JasXSL/VibHub-ESP8266/Devboard_1.1/README.md

# Work in progress

Goal is to correct the errors in rev 1.0 and make additional improvements in the case additional devboard PCBs are made (likely given how cheap that is)

## TODO

~~Swap SDA/SCL pins on ESP8266 and header~~

~~Change I2C address to something not reserved (https://www.i2c-bus.org/addressing/)~~
Uses 0x60

~~Replace resistor array package to fit 0402 that the EXB28V actually uses (never trust what summary descriptions show)~~ Using EXB38V/0603x4 instead

~~Move buttons, obstructed by plugin boards~~

~~Add LED to driver enable/sleep, GPIO15~~

~~Add 0805 resistor (possibly 51R or 220R) to RGB LED 3v3 to limit overall brightness as needed~~

~~Add more spacing between GND pad and pins on DRV8833 package~~

~~Consider switching USB output ports V+ through 2.5mm jack switch to allow using only one port per channel at a time~~

~~Move jacks close to board edge~~

~~Add I2C header for great justice~~
Meh

~~Debug why auto flash and programming doesn't work~~
Reworked circuit, should work now

~~Remove auto boot mode since it may not even work and isn't required~~

~~Add instructions to slikscreen for manual flash boot mode~~
Not enough room to waste for this

~~Add FTDI style header near relocated flash and reboot pins (GND, CTS, VCC, TXD, RXD, RTS)~~

~~Add lables to FTDI header~~

~~Enlarged all text on silkscreen so its readable~~

~~Replace battery input with JST-XH (only needs silkscreen changes and more clearance)~~
Should be enough room now

~~Replace fuse to larger package with higher voltage rating~~

Other things
