JasXSL/VibHub-ESP8266/Devboard_1.0/bom.ods

Qty | Value | Device | Package | Parts | Description | DIGIKEY | MF | MPN
3 | 1.0uF | CAPACITOR-1206 | C1206 | C1, C2, C4 | Capacitors | 1276-1783-1-ND | Samsung | CL31B105KOFNNNE
1 | 100uF/10V | CAPACITOR_POLPANASONIC_D | PANASONIC_D | C12 | Polarized Capacitors | PCE3866CT-ND | Panasonic | EEE-1AA101SP
4 | 10uF/16V | CAPACITOR-1206 | C1206 | C3, C5, C6, C9 | Capacitors | 1276-1312-1-ND | Samsung | CL31F106ZOHNNNE
2 | 0.1uF/16V | CAPACITOR-1206 | C1206 | C7, C10 | Capacitors | 399-9305-1-ND | KEMET | C1206C104K4RACTU
2 | 2.2uF/16V | CAPACITOR-1206 | C1206 | C8, C11 | Capacitors | 490-1799-1-ND | Murata | GRM31MR71C225KA35L
1 | RGB | LED-RGB-CAPLCC | P-LCC-4-3 3528 | D1 | Generic 3528 RGB LED | 732-4998-1-ND | Wurth | 150141M173100
8 | Red | LED0805-NO_OUTLINE | CHIPLED_0805_NOOUTLINE | D13, D14, D15, D16, D17, D18, D19, D20 | Generic 0805 LED | 732-4984-1-ND | Wurth | 150080RS75000
1 | 3A/40V/500mV | DIODE-SCHOTTKY-B340A | SMA-DIODE | D2 | Schottky diode | B340A-FDICT-ND | Diodes Incorporated | B340A-13-F
17 | Blue | LED0805-NO_OUTLINE | CHIPLED_0805_NOOUTLINE | D4, D5, D6, D7, D8, D9, D10, D11, D12, D21, D22, D23, D24, D25, D26, D27, D28 | Generic 0805 LED | 732-4982-1-ND | Wurth | 150080BS75000
1 | 6V/2A | PPTC_HALF-AMP | 1206 | F1 | Resettable Fuse PPTC | 507-1809-1-ND | Bel Fuse Inc. | 0ZCJ0200FF2C
1 | PTH-6.0MM | MOMENTARY-SWITCH-SPST-PTH-6.0MM | TACTILE_SWITCH_PTH_6.0MM | S1 | Momentary Switch (Pushbutton) - SPST | 450-1804-ND | TE Connectivity | 1825910-7
2 | SMD-6.0X3.5MM | MOMENTARY-SWITCH-SPST-SMD-6.0X3.5MM | TACTILE_SWITCH_SMD_6.0X3.5MM | FLASH, RESET | Momentary Switch (Pushbutton) - SPST | 450-1140-ND | TE Connectivity | FSMSM
1 | USB-MICROB-2 | USB-MICROB-2 | USB-MICROB-10118194 | J1 | USB Connectors | 609-4618-6-ND | Amphenol FCI | 10118194-0001LF
4 | MJ-2509N | MJ-2509N | MJ-2509N | J10, J11, J12, J13 | Mono Audio Jack, 2.5 MM | CP-M2509N-ND | CUI | MJ-2509N
2 | 1x2M | CONN_02LOCK_LONGPADS | 1X02_LOCK_LONGPADS | J2, J17 | Generic male header
4 | 1x8F | CONN_08FEMALE_LOCK | 1X08_FEMALE_LOCK | J3, J4, J15, J16 | Generic female header | S7006-ND | Sullins | PPTC081LFBN-RC
2 | 1x8M | CONN_08LOCK | 1X08_LOCK | J5, J14 | Generic male header
4 | USB-A-HU | USB-A-HU | USB-A-HU | J6, J7, J8, J9 | USB Connectors | ED2991-ND | On Shore Technology | USB-A1SSW6
1 | DMG2305UX | MOSFET_PCH | SOT23-3 | Q1 | P-channel MOSFETs | DMG2305UX-7DICT-ND | Diodes Incorporated | DMG2305UX
1 | 51R | RESISTOR0805 | R0805 | R1 | Generic 0805 Resistor | P51ACT-ND | Panasonic | ERJ-6GEYJ510V
1 | 220R | RESISTOR0805 | R0805 | R2 | Generic 0805 Resistor | P220ACT-ND | Panasonic | ERJ-6GEYJ221V
1 | 22R | RESISTOR0805 | R0805 | R3 | Generic 0805 Resistor | P22.0CCT-ND | Panasonic | ERJ-6ENF22R0V
2 | ASDFASDFASDFAS | RESISTOR0805 | R0805 | R4, R5 | Generic 0805 Resistor | P10KACT-ND | Panasonic | ERJ-6GEYJ103V
4 | 0.39R | RESISTOR0805 | R0805 | R6, R7, R8, R9 | Generic 0805 Resistor | P19250CT-ND | Panasonic | ERJ-6DQJR39V
7 | 1k | 743C083102JP | 2008, Concave, Long Side Terminals | RN1, RN2, RN3, RN4, RN5, RN6, RN7 | Array Chip Resistor | 743C083102JPCT-ND | CTS | 743C083102JP
2 | 10k | 743C083103JP | 2008, Concave, Long Side Terminals | RN8, RN9 | Array Chip Resistor | 743C083103JPCT-ND | CTS | 743C083103JP
1 | BSS138PS | BSS138PS | SOT363 | T1 | Dual N-Channel MOSFET | 1727-3125-1-ND | NXP | PMGD280UN,115
1 | PCA9634D | PCA9634 | SO-20 | U1 | IC LED DRIVER 20SO | 568-4065-1-ND | NXP | PCA9634D,118
2 | DRV8833C | DRV8833 | HTSSOP16 | U2, U3 | Dual H-Bridge Motor Driver | 296-40078-1-ND | Texas Instruments | DRV8833CPWPR
1 | 3.3V | V_REG_AP2112K-3.3V | SOT23-5 | U4 | 600mA LDO Regulator | AP2112K-3.3TRG1DICT-ND | Diodes Incorporated | AP2112K-3.3TRG1
1 | ESP12 | ESP-12 | ESP-12 | X1
