JasXSL/VibHub-ESP8266/manual.odt

VibHub Dev Kit 1

By JasX

## User Manual

Important Stuff

- The micro-usb connector (the tiny one) is an INPUT only. The maximum power draw is dependent on the power supply used. DO NOT POWER VIBRATOR UNITS FROM A COMPUTER USB PORT OR YOU WILL BREAK THE PORT. For safety reasons we suggest at least 2.2A of current for your power supply. A 1A supply will work if you only use ONE USB vibrator.
- The large USB ports are OUTPUT only. Do not try to power the device from these.
- Remove any vibrators present when plugging the device into a computer to update the software.

# Legal stuff

## The free hardware

THE PERIPHERAL IS PROVIDED "AS IS", WITHOUT WARRANTY OF ANY KIND, EXPRESS OR IMPLIED, INCLUDING BUT NOT LIMITED TO THE WARRANTIES OF MERCHANTABILITY, FITNESS FOR A PARTICULAR PURPOSE AND NONINFRINGEMENT. IN NO EVENT SHALL THE AUTHORS OR COPYRIGHT HOLDERS BE LIABLE FOR ANY CLAIM, DAMAGES OR OTHER LIABILITY, WHETHER IN AN ACTION OF CONTRACT, TORT OR OTHERWISE, ARISING FROM, OUT OF OR IN CONNECTION WITH THE PERIPHERAL OR THE USE OR OTHER DEALINGS IN THE SOFTWARE.

## The software

Copyright 2018 JasX

Permission is hereby granted, free of charge, to any person obtaining a copy of this software and associated documentation files (the "Software"), to deal in the Software without restriction, including without limitation the rights to use, copy, modify, merge, publish, distribute, sublicense, and/or sell copies of the Software, and to permit persons to whom the Software is furnished to do so, subject to the following conditions:

The above copyright notice and this permission notice shall be included in all copies or substantial portions of the Software.

THE SOFTWARE IS PROVIDED "AS IS", WITHOUT WARRANTY OF ANY KIND, EXPRESS OR IMPLIED, INCLUDING BUT NOT LIMITED TO THE WARRANTIES OF MERCHANTABILITY, FITNESS FOR A PARTICULAR PURPOSE AND NONINFRINGEMENT. IN NO EVENT SHALL THE AUTHORS OR COPYRIGHT HOLDERS BE LIABLE FOR ANY CLAIM, DAMAGES OR OTHER LIABILITY, WHETHER IN AN ACTION OF CONTRACT, TORT OR OTHERWISE, ARISING FROM, OUT OF OR IN CONNECTION WITH THE SOFTWARE OR THE USE OR OTHER DEALINGS IN THE SOFTWARE.

Getting Started

1. Plug a micro USB power outlet, such as a phone charger, of at least 1A (2A+ recommended, see IMPORTANT STUFF). The big LED on the top left quadrant should light up and turn blue.
2. Use a wifi-enabled device such as a smartphone, laptop, tablet, or wifi-enabled PC and look at the list of available connections. Find the one named VibHub_<numbers> such as VibHub_7832 and connect to it.
3. The device should ask you to sign in after connecting. If not, try opening a browser and entering the URL 192.168.4.1 to enter the configuration portal.
4. Press “Configure”.
5. Select the wifi network to connect the device to and enter the password (if any).
6. Write down the Device ID on this page, or change it. Treat this like a password, as this is the token that will allow apps to control your device. If you want to revoke all apps access to your device, change the device ID to something nobody will guess.
7. You can leave the server settings as their default values unless you intend on using a custom or your own server (advanced).
8. Press save and wait for the device to restart.
9. If successful, the big LED at the top left should turn green. If it turns blue again, it means the wifi connection failed. Configure the device again with the right credentials.
10. Plug in a USB or phono vibrator. Keep in mind you can only use one device per channel, so plugging a USB and a phone on channel 0 will not work.
11. Find a VibHub app and enter your device ID. It should now be able to control your VibHub device.

# Reconfiguring

There are 2 ways of reconfiguring the device:

1. Press and hold the button on the board for at least 3 seconds. The light will turn blue and you can enter the configuration portal again.
2. Unplug the device. Press and hold the button while plugging in the device. This will reset all device settings, including WiFi, and generate a new Device ID!

Updating the firmware

V1.0 has a header for the Adafruit CP2104 Friend.

V1.1 will use a standard “FTDI cable” header. Such cables and adapters can be found cheaply from Adafruit, Amazon, or other online stores. The Adafruit CP2104 Friend will also work.

1. Install Arduino IDE https://www.arduino.cc/en/Main/Software
2. Install Arduino ESP8266 via boards manager https://github.com/esp8266/Arduino#installing-with-boards-manager
3. Attach USB-to-UART adapter to programming header. Align according to board markings.
4. Plug adapter’s USB to computer. Install drivers for adapter if needed.
5. Download firmware https://github.com/JasXSL/VibHub-ESP8266
6. Open suitable ino file and change config as needed for board (see git readme for this info)
7. In the Arduino IDE, set the following: Tools > Board > NodeMCU 1.0 Tools > Upload Speed > 115200 Tools > Ports > select the COM port for the adapter you’ve plugged in (likely the only one)
8. On the VibHub board, hold down the FLASH button, press RESET, then release FLASH.
9. Sketch > Upload
10. Wait

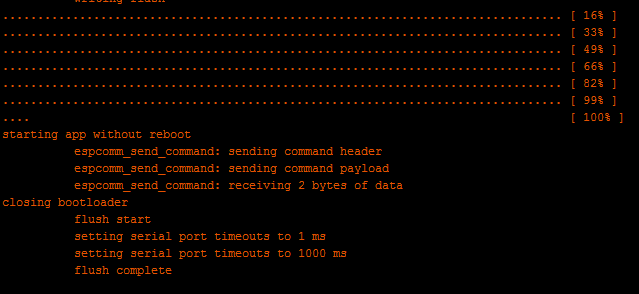
[picture p1: figure]

11. The following means it completed successfully.
12. Profit.

Need additonal help?

Join the JasX discord at discord.jasx.org

Credits

JasX is:

- JasXSL: https://github.com/JasXSL
- Kadah: https://github.com/Kadah

Additional open source/creative commons libraries/assets by:

- WiFiManager by Tzapu: https://github.com/tzapu/WiFiManager
- TweenDuino by StickyWes: https://github.com/stickywes/TweenDuino
- PCA9634 by HydroSense: https://github.com/HydroSense/HydroSense_PCA9634 (https://github.com/HydroSense/HydroSense_PCA9634)
- Padlock icon by game-icons: https://game-icons.net/

TODO: Fill out the rest
