JasXSL/VibHub-ESP8266/(threads)

Thread 2 (2018-01-17):

To do: Select wifi credentials, device ID and server URL via bluetooth.

JasXSL, 2018-01-17:
Also store them on file.

- [ ] Script bluetooth back-end
- [ ] Script bluetooth front end
- [ ] Add read/write of values onto file
- [ ] Add HW button to enable bluetooth
- [ ] Add RGB status LED.

JasXSL, 2018-02-02:
Closing since we're going with the wifi implementation

Closed 2018-02-02.

Thread 3 (2018-01-17):

Device disconnects and reconnects a lot, problem with HW or SW?

JasXSL, 2018-01-17:
Dunno why it does this, but I've set it up to reconnect at least, so it shouldn't be that big of an issue. Might wanna look into it some time tho.

JasXSL, 2018-02-02:
Seems to be fixed with the latest library I think

Closed 2018-02-02.

Thread 4 (2018-01-17):

To do: Programs

JasXSL, 2018-01-17:
Right now the device only supports setting PWM values directly. The node version of VibHub supports programs where it tweens between values. Not sure if we'll have enough memory to do it, but it's probably worth looking into.

JasXSL, 2018-05-02:
Next step will be:

- [ ] Support the GET socket task to load programs via sockets
- [ ] Support RandObj and boolean (use previous) in stage intensity
- [ ] Support RandObj in stage duration
- [ ] Support RandObj in stage repeats

Thread 6 (2018-05-02):

Device shut down without restarting after first wifi settings

JasXSL, 2018-05-02:
Anything past that reboots properly. Maybe an issue of the first write to the file system?

Thread 7 (2018-05-04):

Additional socket tasks needed

JasXSL, 2018-05-04:
Currently I believe we're only accepting "p". The following will also need to be supported:

- [ ] ps - Set a single motor PWM (this could possibly be used for your reverse brake if you wanted)
- GET - Sends a REST request via websockets instead. Only needs to implement the "vib" task
