JasXSL/VibHub-ESP8266/Hardware/vibhub_0.2.pdf

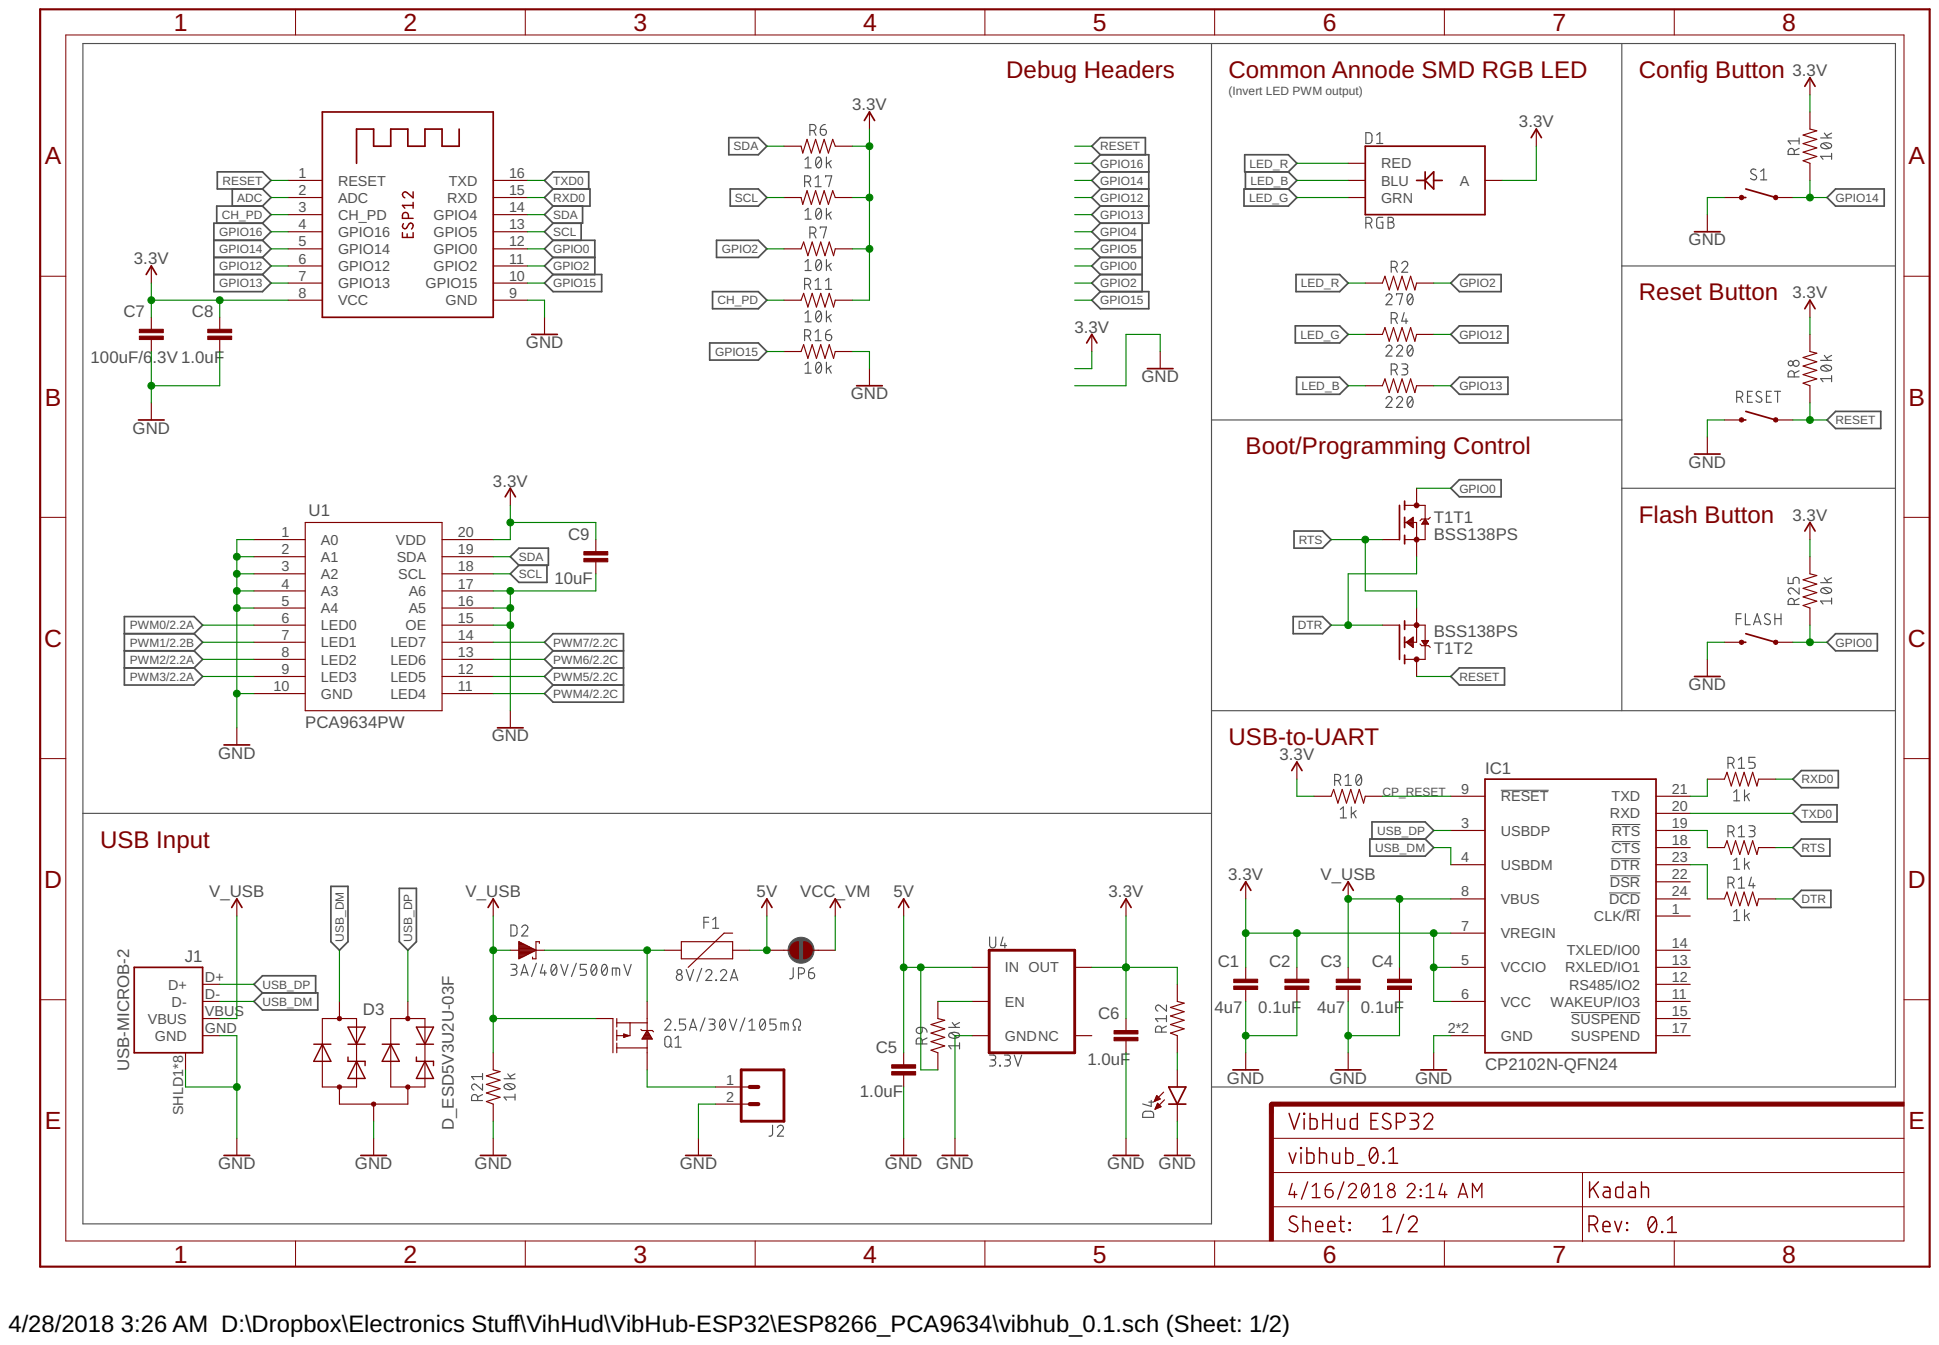
[picture p2: page 1]

Debug Headers 3.3V | Common Annode SMD RGB LED (Invert LED PWM output) 3.3V | Config Button 3.3V

Flash Button 3.3V

5 | 16 A6
6 | 15 A5
7 | 14 OE

4/28/2018 3:26 AM D:\Dropbox\Electronics Stuff\VihHud\VibHub-ESP32\ESP8266_PCA9634\vibhub_0.1.sch (Sheet: 1/2)
