JasXSL/VibHub-ESP8266/Hardware/vibhub_0.1.pdf

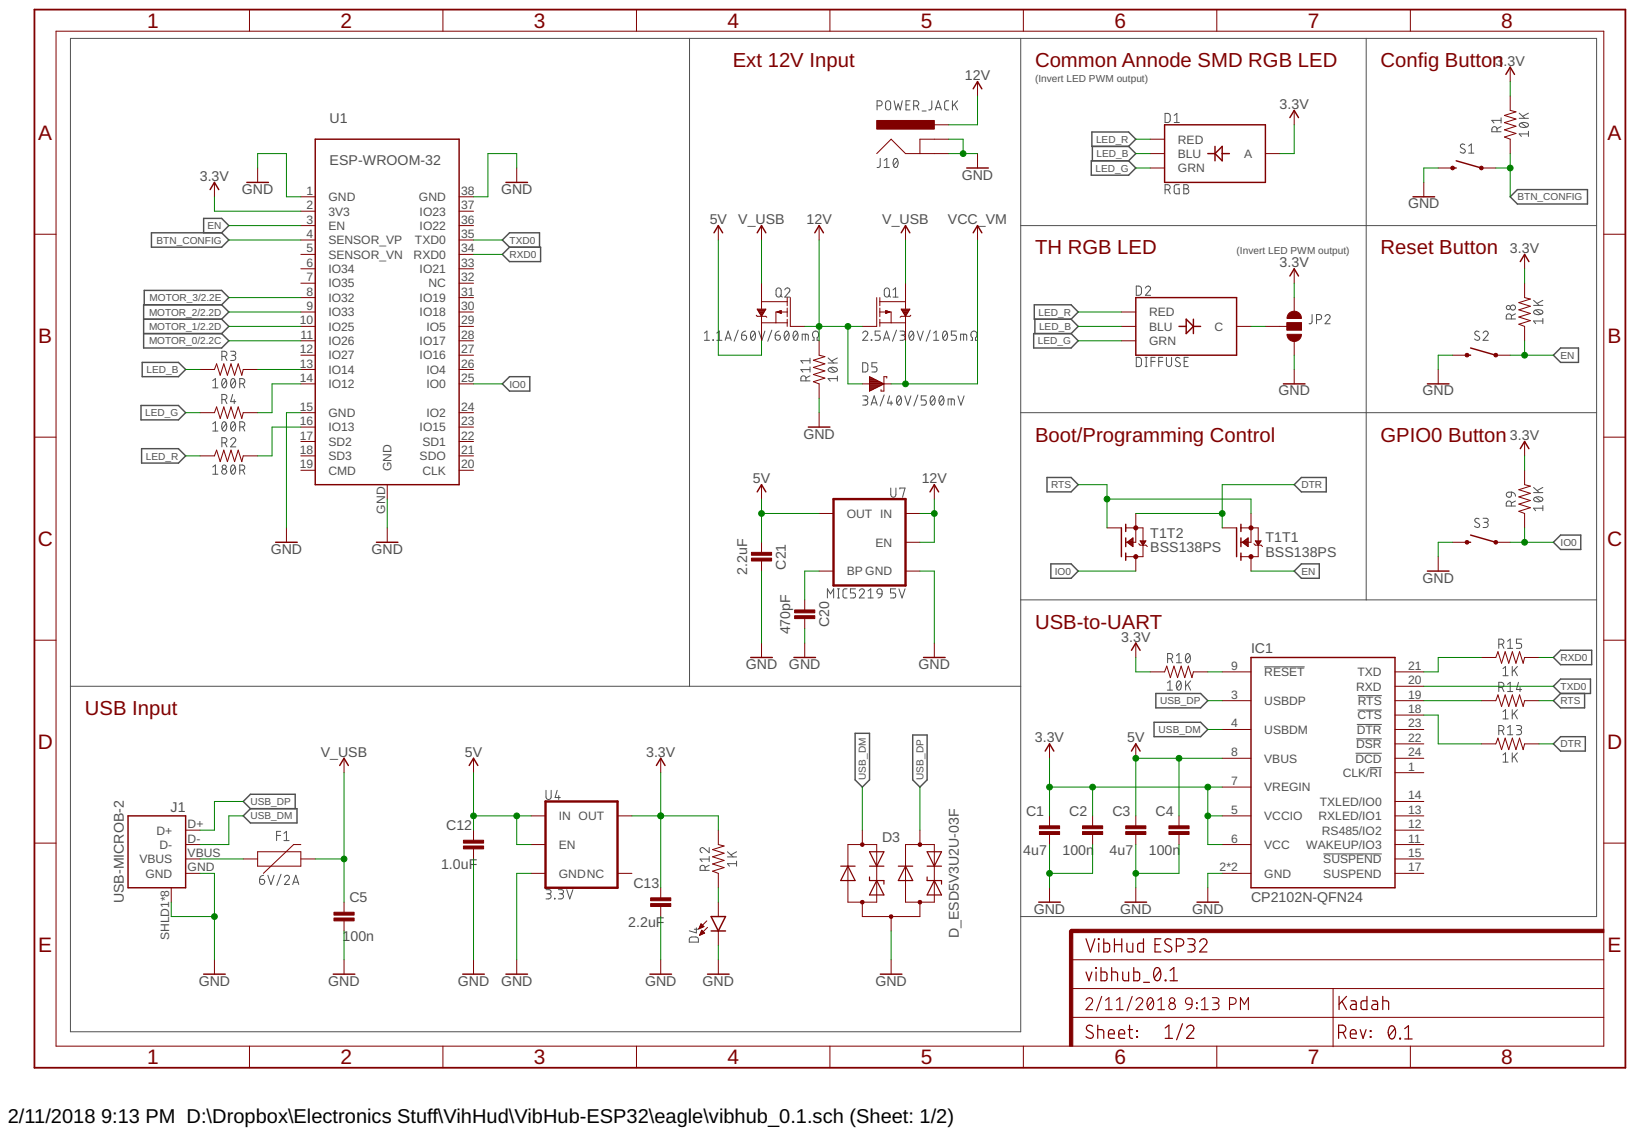
[picture p3: page 1]

(Invert LED PWM output)

IN GND OUT EN

2/11/2018 9:13 PM D:\Dropbox\Electronics Stuff\VihHud\VibHub-ESP32\eagle\vibhub_0.1.sch (Sheet: 1/2)

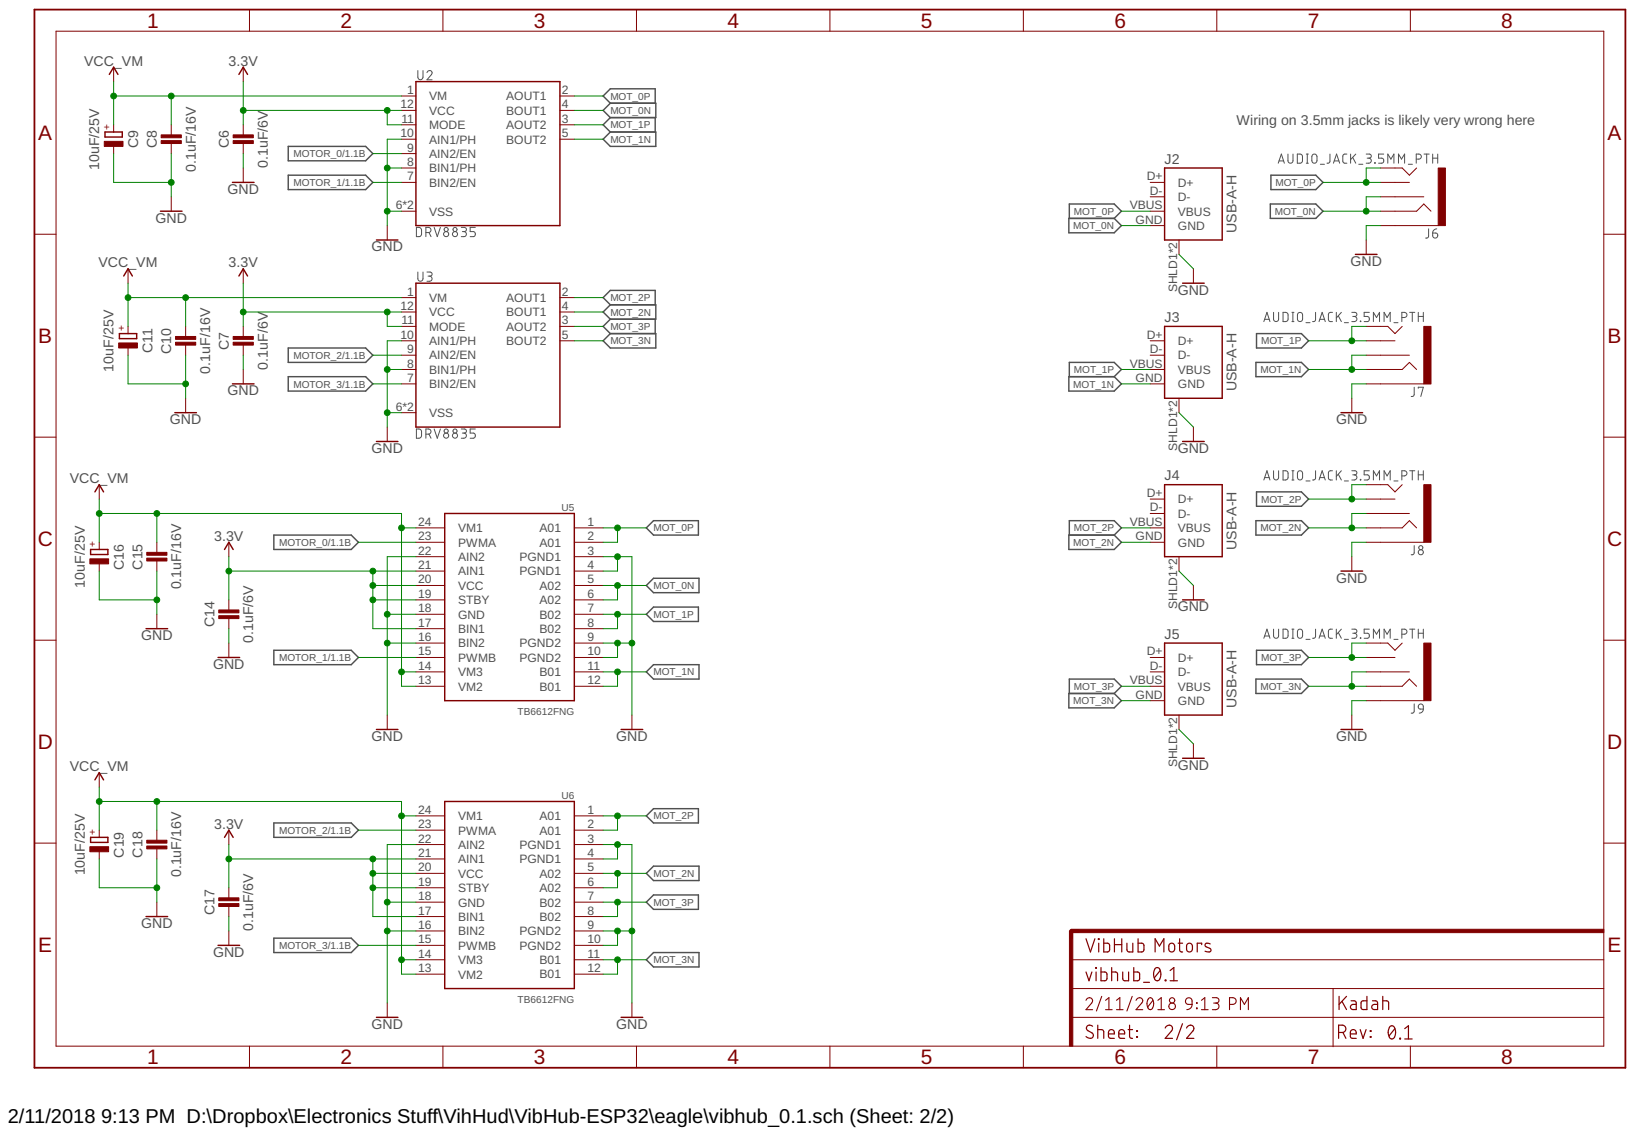
[picture p4: page 2]
