JasXSL/VibHub-ESP8266/Devboard_1.1/devboard.brd

## EAGLE design Devboard_1.1/devboard.brd (2018-06-25)

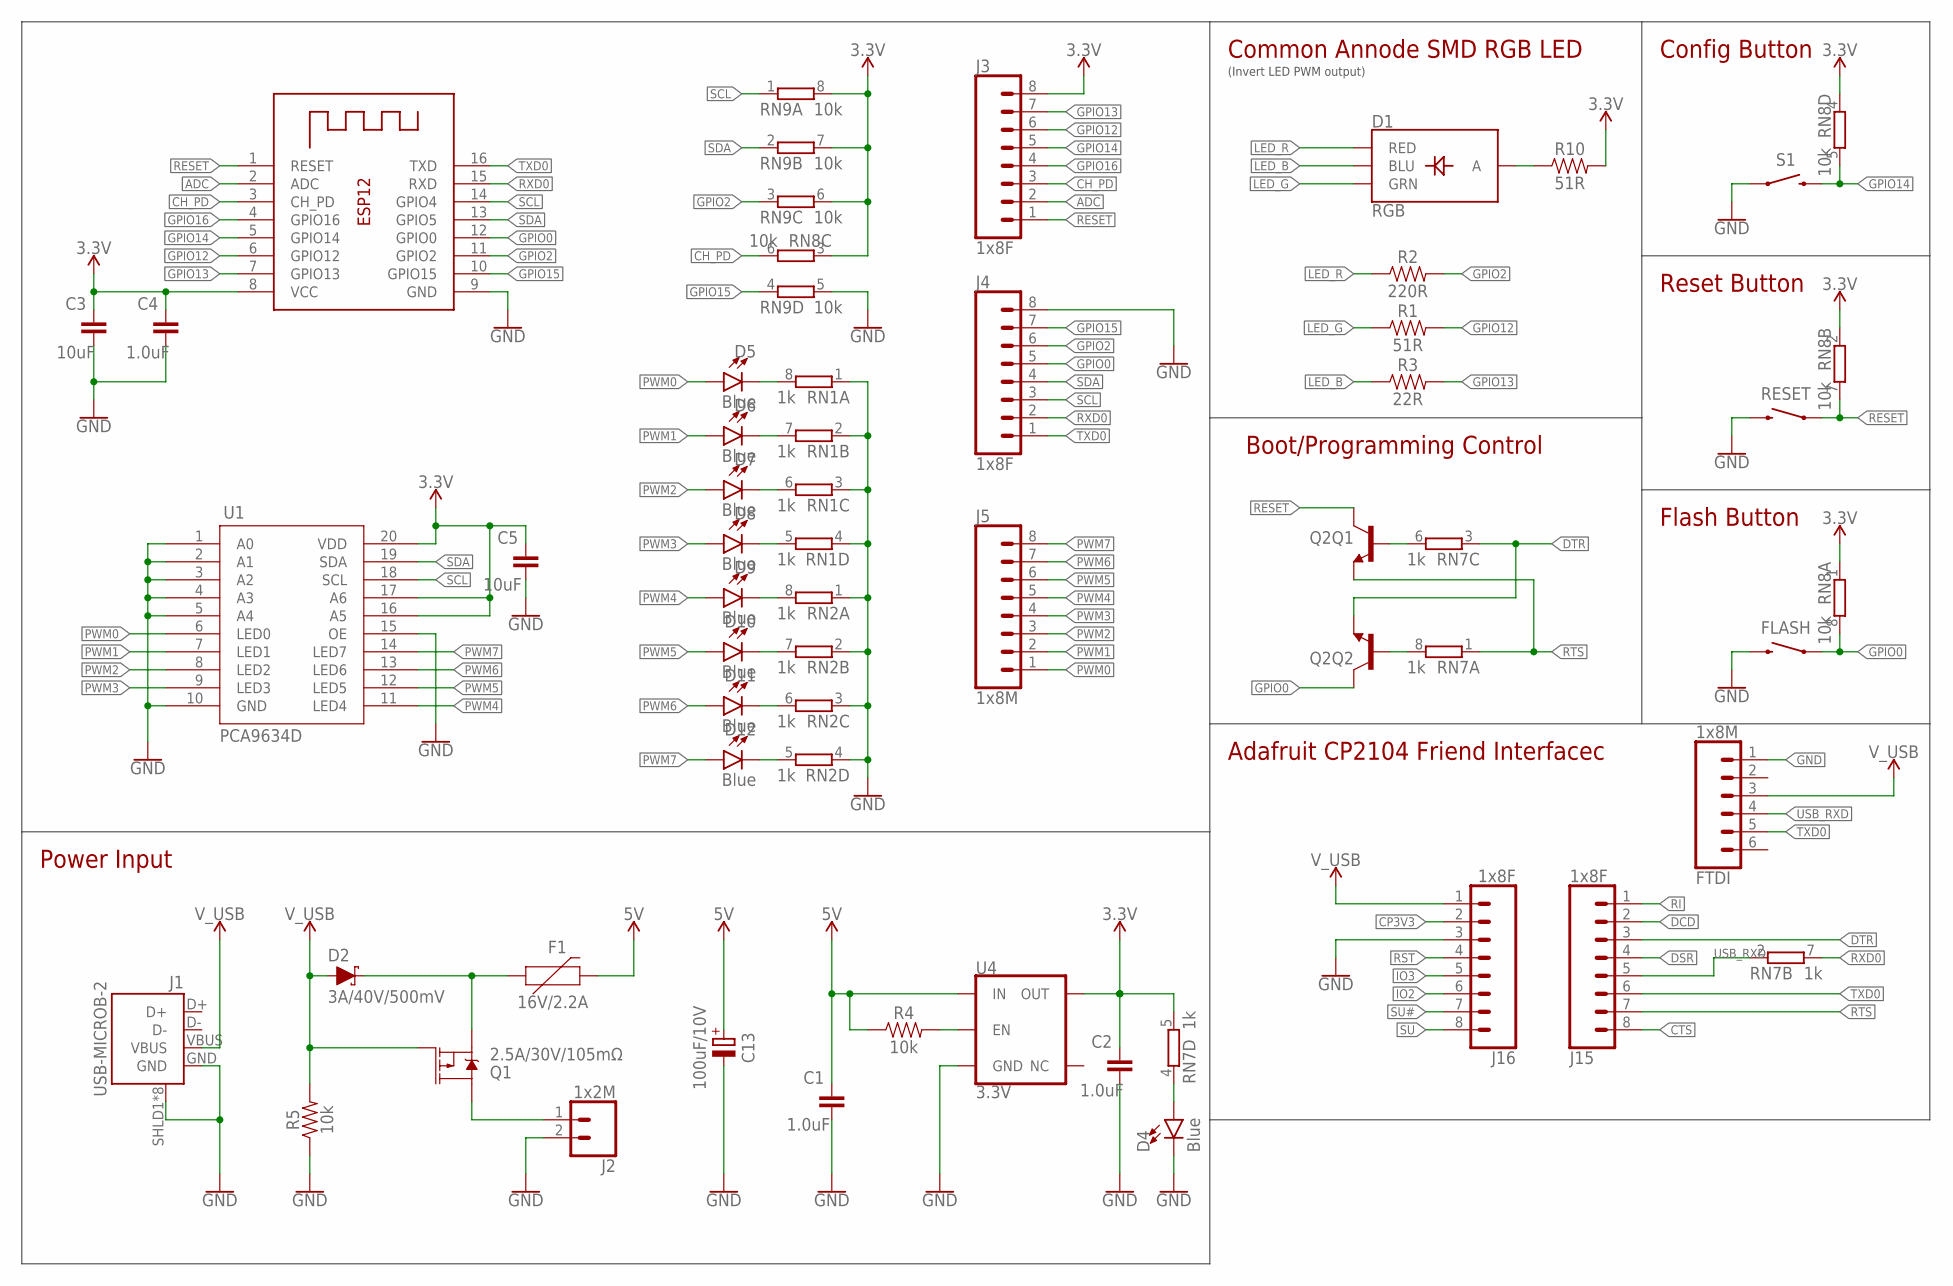
[picture p5: schematic devboard.sch, sheet 1]

Parts:
C1, C2, C4: 1.0uF; C0805
C3, C5: 10uF; C0805
C13: 100uF/10V; PANASONIC_D
D1: RGB; P-LCC-4-3
D2: 3A/40V/500mV; SMA-DIODE
D4, D5, D6, D7, D8, D9, D10, D11, D12: Blue; CHIPLED_0805_NOOUTLINE
F1: 16V/2.2A; FUSC7035X90
FLASH: MOMENTARY-SWITCH-SPST-SMD-6.0X3.5MM; TACTILE_SWITCH_SMD_6.0X3.5MM
FTDI: 1x8M; 1X06_LOCK
J1: USB-MICROB-2; USB-MICROB-10118194
J2: 1x2M; 1X02_LOCK_LONGPADS
J3, J4, J15, J16: 1x8F; 1X08_FEMALE_LOCK
J5: 1x8M; 1X08_LOCK
Q1: 2.5A/30V/105mΩ; SOT23-3
Q2: TRANS_NPN_DUAL-MBT3904DW1T1; SC70-6
R1, R10: 51R; 0805
R2: 220R; 0805
R3: 22R; 0805
R4, R5: 10k; 0805
RESET: MOMENTARY-SWITCH-SPST-SMD-6.0X3.5MM; TACTILE_SWITCH_SMD_6.0X3.5MM
RN1, RN2, RN7: 1k; EXB28V
RN8, RN9: 10k; EXB28V
S1: MOMENTARY-SWITCH-SPST-PTH-6.0MM; TACTILE_SWITCH_PTH_6.0MM
U1: PCA9634D; SOIC127P1032X265-20
U4: 3.3V; SOT23-5
X1: ESP12; ESP-12

Connections:
3.3V: C2.1, C3.1, C4.1, C5.1, J3.8, R10.2, RN7.5 (2), RN8.1, RN8.2 (1), RN8.3 (1), RN8.4 (1), RN9.6 (2), RN9.7 (2), RN9.8 (2), U1.16 (A5), U1.17 (A6), U1.20 (VDD), U4.5 (OUT), X1.8 (VCC); also elsewhere on the board
5V: C1.1, C13.+, F1.2, R4.1, U4.1 (IN); also elsewhere on the board
ADC: J3.2, X1.2 (ADC)
CH_PD: J3.3, RN8.6 (2), X1.3 (CH_PD)
CP3V3: J16.2
CTS: J15.8
DCD: J15.2
DSR: J15.4
DTR: J15.3, Q2.1 (E), RN7.3 (1)
GND: C1.2, C2.2, C3.2, C4.2, C5.2, C13.-, D4.C, FLASH.2, FTDI.1, J1.GND, J1.SHLD1 (SHIELD), J1.SHLD2 (SHIELD), J1.SHLD3 (SHIELD), J1.SHLD4 (SHIELD), J1.SHLD5 (SHIELD), J1.SHLD6 (SHIELD), J1.SHLD7 (SHIELD), J1.SHLD8 (SHIELD), J2.2, J4.8, J16.3, R5.1, RESET.2, RN1.1, RN1.2 (1), RN1.3 (1), RN1.4 (1), RN2.1, RN2.2 (1), RN2.3 (1), RN2.4 (1), RN9.5 (2), S1.1, U1.1 (A0), U1.2 (A1), U1.3 (A2), U1.4 (A3), U1.5 (A4), U1.10 (GND), U1.15 (OE), U4.2 (GND), X1.9 (GND); also elsewhere on the board
GPIO0: FLASH.1, J4.5, Q2.6 (C), RN8.8 (2), X1.12 (GPIO0)
GPIO2: J4.6, R2.2, RN9.3 (1), X1.11 (GPIO2)
GPIO12: J3.6, R1.2, X1.6 (GPIO12)
GPIO13: J3.7, R3.2, X1.7 (GPIO13)
GPIO14: J3.5, RN8.5 (2), S1.3 (2), X1.5 (GPIO14)
GPIO15: J4.7, RN9.4 (1), X1.10 (GPIO15); also elsewhere on the board
GPIO16: J3.4, X1.4 (GPIO16)
IO2: J16.6
IO3: J16.5
LED_B: D1.3 (BLU), R3.1
LED_G: D1.2 (GRN), R1.1
LED_R: D1.1 (RED), R2.1
unnamed: R4.2, U4.3 (EN)
unnamed: D5.C, RN1.8 (2)
unnamed: D6.C, RN1.7 (2)
unnamed: J2.1, Q1.3 (D)
unnamed: D2.C, F1.1, Q1.2 (S)
unnamed: D7.C, RN1.6 (2)
unnamed: D8.C, RN1.5 (2)
unnamed: D9.C, RN2.8 (2)
unnamed: D10.C, RN2.7 (2)
unnamed: D11.C, RN2.6 (2)
unnamed: D12.C, RN2.5 (2)
unnamed: D1.4 (A), R10.1
unnamed: Q2.2 (B), RN7.8 (2)
unnamed: Q2.5 (B), RN7.6 (2)
PWM0: D5.A, J5.1, U1.6 (LED0); also elsewhere on the board
PWM1: D6.A, J5.2, U1.7 (LED1); also elsewhere on the board
PWM2: D7.A, J5.3, U1.8 (LED2); also elsewhere on the board
PWM3: D8.A, J5.4, U1.9 (LED3); also elsewhere on the board
PWM4: D9.A, J5.5, U1.11 (LED4); also elsewhere on the board
PWM5: D10.A, J5.6, U1.12 (LED5); also elsewhere on the board
PWM6: D11.A, J5.7, U1.13 (LED6); also elsewhere on the board
PWM7: D12.A, J5.8, U1.14 (LED7); also elsewhere on the board
PWR_LED: D4.A, RN7.4 (1)
RESET: J3.1, Q2.3 (C), RESET.1, RN8.7 (2), X1.1 (RESET)
RI: J15.1
RST: J16.4
RTS: J15.7, Q2.4 (E), RN7.1
RXD0: J4.2, RN7.7 (2), X1.15 (RXD)
SCL: J4.3, RN9.1, U1.18 (SCL), X1.14 (GPIO4)
SDA: J4.4, RN9.2 (1), U1.19 (SDA), X1.13 (GPIO5)
SU: J16.8
SU#: J16.7
TXD0: FTDI.5, J4.1, J15.6, X1.16 (TXD)
USB_RXD: FTDI.4, J15.5, RN7.2 (1)
V_USB: D2.A, FTDI.3, J1.VBUS, J16.1, Q1.1 (G), R5.2

Notes on the sheet:
(Invert LED PWM output)
Reset Button
Config Button
Common Annode SMD RGB LED
Boot/Programming Control
Adafruit CP2104 Friend Interfacec
Power Input
Flash Button

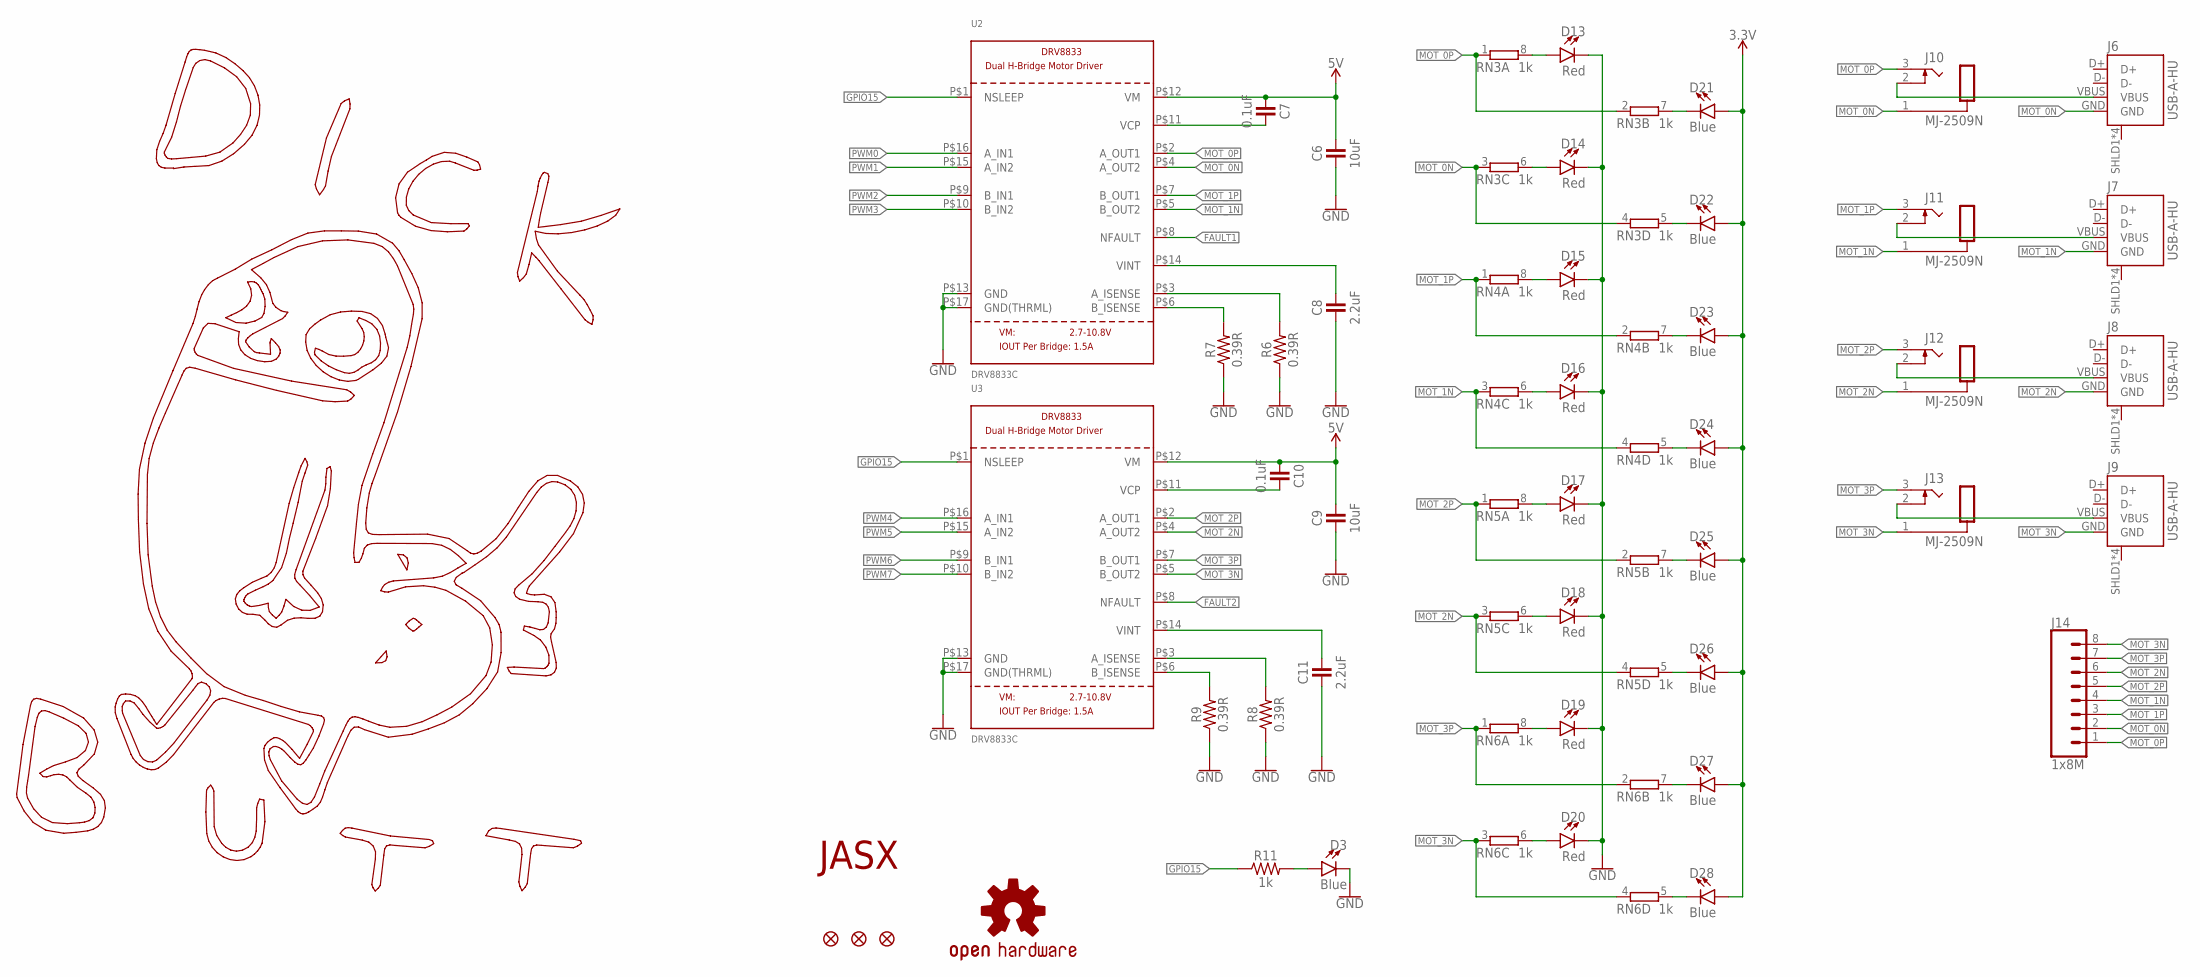
[picture p6: schematic devboard.sch, sheet 2]

Parts:
C6, C9: 10uF; C0805
C7, C10: 0.1uF; C0805
C8, C11: 2.2uF; C0805
D3, D21, D22, D23, D24, D25, D26, D27, D28: Blue; CHIPLED_0805_NOOUTLINE
D13, D14, D15, D16, D17, D18, D19, D20: Red; CHIPLED_0805_NOOUTLINE
FD1, FD2, FD3: FIDUCIAL1X2; FIDUCIAL-1X2
J6, J7, J8, J9: USB-A-HU
J10, J11, J12, J13: MJ-2509N
J14: 1x8M; 1X08_LOCK
LOGO1: OSHW-LOGOM; OSHW-LOGO-M
R6, R7, R8, R9: 0.39R; 0805
R11: 1k; 0805
RN3, RN4, RN5, RN6: 1k; EXB28V
U2, U3: DRV8833C; HTSSOP16
U$1: DICKBUTTCOPPER; DICKBUTT_COPPER
U$2: JASX_LOGO_LARGE; JASX_LOGO

Connections:
3.3V: D21.A, D22.A, D23.A, D24.A, D25.A, D26.A, D27.A, D28.A; also elsewhere on the board
5V: C6.2, C7.1, C9.2, C10.1, U2.P$12 (VM), U3.P$12 (VM); also elsewhere on the board
A_ISENSE0: R6.2, U2.P$3 (A_ISENSE)
A_ISENSE1: R8.2, U3.P$3 (A_ISENSE)
B_ISENSE0: R7.2, U2.P$6 (B_ISENSE)
B_ISENSE1: R9.2, U3.P$6 (B_ISENSE)
FAULT1: U2.P$8 (NFAULT)
FAULT2: U3.P$8 (NFAULT)
GND: C6.1, C8.1, C9.1, C11.1, D3.C, D13.C, D14.C, D15.C, D16.C, D17.C, D18.C, D19.C, D20.C, R6.1, R7.1, R8.1, R9.1, U2.P$13 (GND), U2.P$17 (GND(THRML)), U3.P$13 (GND), U3.P$17 (GND(THRML)); also elsewhere on the board
GPIO15: R11.1, U2.P$1 (NSLEEP), U3.P$1 (NSLEEP); also elsewhere on the board
MOT_0N: J6.GND, J10.1 (S), J14.2, RN3.3 (1), RN3.4 (1), U2.P$4 (A_OUT2)
MOT_0P: J10.3 (T), J14.1, RN3.1, RN3.2 (1), U2.P$2 (A_OUT1)
MOT_1N: J7.GND, J11.1 (S), J14.4, RN4.3 (1), RN4.4 (1), U2.P$5 (B_OUT2)
MOT_1P: J11.3 (T), J14.3, RN4.1, RN4.2 (1), U2.P$7 (B_OUT1)
MOT_2N: J8.GND, J12.1 (S), J14.6, RN5.3 (1), RN5.4 (1), U3.P$4 (A_OUT2)
MOT_2P: J12.3 (T), J14.5, RN5.1, RN5.2 (1), U3.P$2 (A_OUT1)
MOT_3N: J9.GND, J13.1 (S), J14.8, RN6.3 (1), RN6.4 (1), U3.P$5 (B_OUT2)
MOT_3P: J13.3 (T), J14.7, RN6.1, RN6.2 (1), U3.P$7 (B_OUT1)
unnamed: D3.A, R11.2
unnamed: J9.VBUS, J13.2 (TS)
unnamed: D21.C, RN3.7 (2)
unnamed: D13.A, RN3.8 (2)
unnamed: D14.A, RN3.6 (2)
unnamed: D15.A, RN4.8 (2)
unnamed: D16.A, RN4.6 (2)
unnamed: D17.A, RN5.8 (2)
unnamed: D18.A, RN5.6 (2)
unnamed: D19.A, RN6.8 (2)
unnamed: D20.A, RN6.6 (2)
unnamed: D22.C, RN3.5 (2)
unnamed: D23.C, RN4.7 (2)
unnamed: D24.C, RN4.5 (2)
unnamed: D28.C, RN6.5 (2)
unnamed: D27.C, RN6.7 (2)
unnamed: D26.C, RN5.5 (2)
unnamed: D25.C, RN5.7 (2)
unnamed: J6.VBUS, J10.2 (TS)
unnamed: J7.VBUS, J11.2 (TS)
unnamed: J8.VBUS, J12.2 (TS)
PWM0: U2.P$16 (A_IN1); also elsewhere on the board
PWM1: U2.P$15 (A_IN2); also elsewhere on the board
PWM2: U2.P$9 (B_IN1); also elsewhere on the board
PWM3: U2.P$10 (B_IN2); also elsewhere on the board
PWM4: U3.P$16 (A_IN1); also elsewhere on the board
PWM5: U3.P$15 (A_IN2); also elsewhere on the board
PWM6: U3.P$9 (B_IN1); also elsewhere on the board
PWM7: U3.P$10 (B_IN2); also elsewhere on the board
VCP0: C7.2, U2.P$11 (VCP)
VCP1: C10.2, U3.P$11 (VCP)
VINT0: C8.2, U2.P$14 (VINT)
VINT1: C11.2, U3.P$14 (VINT)

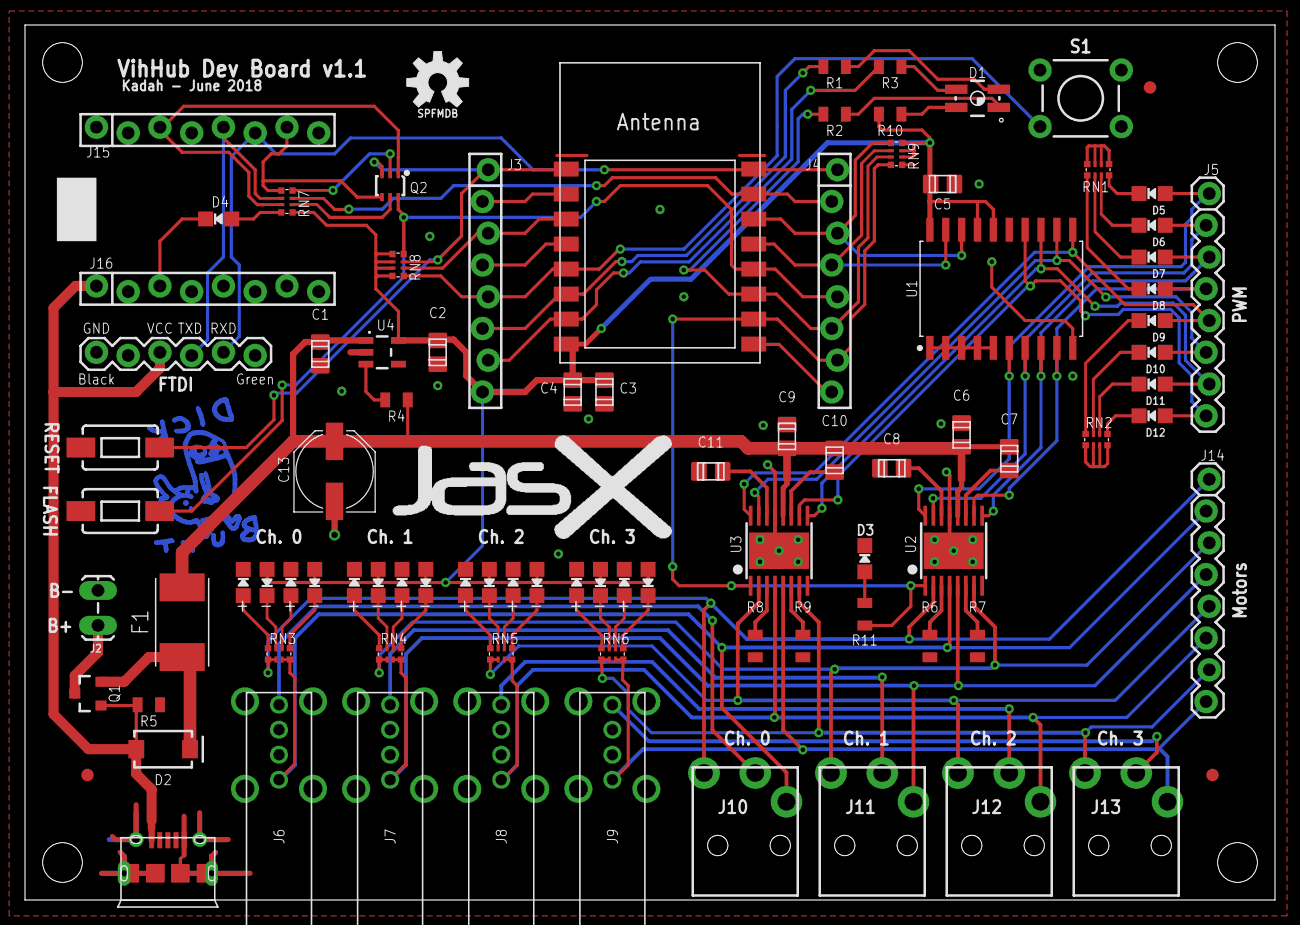
[picture p7: board devboard.brd from above]

Board: 2 copper layers, 100.0 x 70.0 mm, 94 parts (1 on the bottom side), 84 nets.
