JasXSL/VibHub-ESP8266/CaptivePortal_i2c/VhMotor.h

/*
	VibHub motor data
*/
#ifndef VhMotor_h
#define VhMotor_h
#include "VhPwm.h"
#include <vector>
#include <ArduinoJson.h> // https://github.com/bblanchon/ArduinoJson
#include "TweenProgram.h"

// Motor class extending PWM class
class VhMotor: public VhPwm{

	public:
		VhMotor( int channel );
		void loadProgram( JsonArray stages, int repeats );
		void update();
        void setPWM( int duty, bool fast_decay = false, bool forward = false );
		void stopProgram();
		TweenProgram program;

    protected:
        int _channel;
        float _duty;
};

#endif
