JasXSL/VibHub-ESP8266/CaptivePortal_i2c/VhSocketIoClient.cpp

/*
	VibHub Socket.io
    
    A fork of https://github.com/timum-viw/socket.io-client
    
    Contains specifically needed modifications for Vh
    Main changes:
        ESP32 compatibility
        Fire "disconnect" for connection lost as well (may fire more than once as a result)
*/

#include "VhSocketIoClient.h"
#include "Configuration.h"

SocketIoClient::SocketIoClient(void){
    _webSocket.setReconnectInterval(WEBSOCKET_RECONNECT_TIME);
}

const String getEventName(const String msg) {
	return msg.substring(4, msg.indexOf("\"",4));
}

const String getEventPayload(const String msg) {
	String result = msg.substring(msg.indexOf("\"",4)+2,msg.length()-1);
	if(result.startsWith("\"")) {
		result.remove(0,1);
	}
	if(result.endsWith("\"")) {
		result.remove(result.length()-1);
	}
	return result;
}

void SocketIoClient::webSocketEvent(WStype_t type, uint8_t * payload, size_t length) {
	String msg;
	switch(type) {
		case WStype_DISCONNECTED:
			SOCKETIOCLIENT_DEBUG("[SIoC] Disconnected!\n");
            trigger("disconnect", NULL, 0); //KC: also dire disconnect when connection to server is lost
			break;
		case WStype_CONNECTED:
			SOCKETIOCLIENT_DEBUG("[SIoC] Connected to url: %s\n",  payload);
			break;
		case WStype_TEXT:
			msg = String((char*)payload);
			if(msg.startsWith("42")) {
				trigger(getEventName(msg).c_str(), getEventPayload(msg).c_str(), length);
			} else if(msg.startsWith("2")) {
				_webSocket.sendTXT("3");
			} else if(msg.startsWith("40")) {
				trigger("connect", NULL, 0);
			} else if(msg.startsWith("41")) {
				trigger("disconnect", NULL, 0);
			}
			break;
		case WStype_BIN:
			SOCKETIOCLIENT_DEBUG("[SIoC] get binary length: %u\n", length);
			// hexdump(payload, length);
			SOCKETIOCLIENT_DEBUG("0x%", payload);
		break;
	}
}

void SocketIoClient::beginSSL(const char* host, const int port, const char* url, const char* fingerprint) {
	_webSocket.beginSSL(host, port, url, fingerprint);
    initialize();
}

void SocketIoClient::begin(const char* host, const int port, const char* url) {
	_webSocket.begin(host, port, url);
    initialize();
}

void SocketIoClient::initialize() {
    _webSocket.onEvent(std::bind(&SocketIoClient::webSocketEvent, this, std::placeholders::_1, std::placeholders::_2, std::placeholders::_3));
	_lastPing = millis();
}

void SocketIoClient::loop() {
	_webSocket.loop();
	for(auto packet=_packets.begin(); packet != _packets.end();) {
		if(_webSocket.sendTXT(*packet)) {
			SOCKETIOCLIENT_DEBUG("[SIoC] packet \"%s\" emitted\n", packet->c_str());
			packet = _packets.erase(packet);
		} else {
			++packet;
		}
	}

	if(millis() - _lastPing > PING_INTERVAL) {
		_webSocket.sendTXT("2");
		_lastPing = millis();
	}
}

void SocketIoClient::on(const char* event, std::function<void (const char * payload, size_t length)> func) {
	_events[event] = func;
}

void SocketIoClient::emit(const char* event, const char * payload) {
	String msg = String("42[\"");
	msg += event;
	msg += "\"";
	if(payload) {
		msg += ",";
		msg += payload;
	}
	msg += "]";
	SOCKETIOCLIENT_DEBUG("[SIoC] add packet %s\n", msg.c_str());
	_packets.push_back(msg);
}

void SocketIoClient::trigger(const char* event, const char * payload, size_t length) {
	auto e = _events.find(event);
	if(e != _events.end()) {
		SOCKETIOCLIENT_DEBUG("[SIoC] trigger event %s\n", event);
		e->second(payload, length);
	} else {
		SOCKETIOCLIENT_DEBUG("[SIoC] event %s not found. %d events available\n", event, _events.size());
	}
}

void SocketIoClient::disconnect()
{
	_webSocket.disconnect();
	// trigger("disconnect", NULL, 0);
}
