JasXSL/VibHub-ESP8266/CaptivePortal_i2c/TweenRandObject.cpp

#include "TweenRandObject.h"
#include <arduino.h>
#include "Configuration.h"
void TweenRandObject::load(JsonVariant data){
	reset();

	if(data.is<bool>())
		isFalse = true;

	else if(data.is<int>())
		min = max = data.as<int>();
	
	else if(data.is<JsonObject>()){

		JsonObject d = data.as<JsonObject>();
		if(d.containsKey("min"))
			min = d["min"];
		if(d.containsKey("max"))
			max = d["max"];
		if(d.containsKey("offset"))
			offset = d["offset"];
		if(d.containsKey("multi"))
			multi = d["multi"];
			
	}
	else
		Serial.println("RandObject is INVALID");


}

int TweenRandObject::getValue( uint8_t inValue ){

	if( isFalse )
		return inValue;
		
	int out = random(min, max+1)*multi+offset;
	//Serial.printf("Returning a random value between min %i, max %i, multi %i, offset %i: %i\n", min, max, multi, offset, out);
	return out;
	
}


void TweenRandObject::reset(){
	min = 0;
	max = 0;
	offset = 0;
	multi = 1;
	isFalse = false;
}
