JasXSL/VibHub-ESP8266/(commit log)

2018-01-17 It twerks!
    You'll have to specify your wifi credentials, but you can now control PWM of a single pin via the websocket API.
2018-01-17 Add library
    Added modified version of library: washo4evr/Socket.io-v1.x-Library
2018-01-19 Add Config library with read/write to file, also connection library
    It doesn't work. But it compiles and doesn't crash. Around here we call that a win!
    [Config.cpp, Config.h]
2018-01-22 Added config and connection to CaptivePortal Refactored config for JSON and added ESP8266 support Enabled debug on websockets Added flash format to reset function
    [Config.cpp, Config.h]
2018-01-24 Compiles for ESP32 now but doesn't work due to current library flux
    [Config.cpp]
2018-01-29 Added CaptivePortal2 which supports both ESP8266 and ESP32
2018-01-30 Updated pins for ESP32 devkit board
2018-01-30 Added support for Adafruit Motor Shield v2 (buggy)
2018-01-31 Jas ESP32 Attempt
    Took out the motor stuff for now. Next will be to improve the captive portal.
2018-01-31 PWM LED control
2018-01-31 Add back my old motor control
    This will work with my 4x motor controller chip that I have at hand. It's PWM, not rocket science :cat:
2018-01-31 Change the wifi-reset button to a winfi-config button
    When touched while the app is running, the wifi will enter config mode without resetting the data. Hitting the exit button on the front page now also closes the connection and restarts.
    Also adds a parameter to the wifi manager with device ID, however, this doesn't seem to work. I've created an issue request on the original library.
2018-02-01 Added captive portal config Added Config class and moved wifimanager to that Removed motor lib, was broken
    [Config.cpp, Config.h]
2018-02-01 Updates to LED etc
    - Moved all filesystem config values into Config library.
    - Structured the code a bit for easier collapsing
    - Added program "states" which are signalled by the power of LEDs.
    - Moved the current motor implementation into VhPwm which is a generic class to easily setup and control GPIO PWM.
    - Added a motor class that extends VhPwm, but will later use to add additional functionality to motors (Programs).
    - Added reset detection by holding the button for 5 sec.
    - Added button debouncing.
    - Removed my test template for the HTML. I'll get to work on stylizing it and adding the rest of the config values tomorrow.
    [Config.cpp, Config.h, VhPwm.cpp, VhPwm.h]
2018-02-02 Split Wifi, Socket.io, led, config in to their own classes Cleaned up the ino a lot Added invert to VhPmw Added Configuration.h for common settings Changed motor control class to global single Droppi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
    [Configuration.h]
2018-02-02 Added ESP32 pin map
    [ESP32 Devboard Pins.ods]
2018-02-02 Reset to factory on reboot
    Holding button while booting now resets to factory
    [Config.cpp, Config.h]
2018-02-03 Added basic schematic
    [vibhub_0.1.sch]
2018-02-03 Restructured VhSocket class as child of SocketIoClient for greater flexiblity
2018-02-03 Added button UI demo Updated Config
    [Configuration.h]
2018-02-05 Large update and restructuring Button UI implemented Moved button handling to its own class Added SocketIoClass fork Fixed disconnect event Change SocketIO wrapper to Client Fixed SocketIO disconnect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
    [Configuration.h]
2018-02-06 Modified how LED_INVERT works
    [Configuration.h]
2018-02-06 Added pulse effect to LED
2018-02-06 Increase max stages
    Changed max stages of timelines to 64. ESP32 should definitely have enough memory for that.
2018-02-07 Added USB-to-UART interface
    [vibhub_0.1.sch]
2018-02-09 Added Jas's motor code
    [Configuration.h, ESP32 Devboard Pins.ods]
2018-02-09 Added input protection Added motor drivers Added motor outputs Added 12V DC input (motors only) Untested, will likely catch fire
    [vibhub_0.1.sch]
2018-02-09 Added TB6612FNG driver option to schematic
    [vibhub_0.1.sch]
2018-02-12 Fleshed out the external power better This more likely will work now
    [vibhub_0.1.sch]
2018-02-19 Added ESP8266
    [Configuration.h]
2018-02-19 Add motor update
    Feel free to revise to make it prettier and better. This makes programs work at least :3
2018-02-19 Added ESP8266 support to main code
    [Configuration.h]
2018-04-28 Added initial ESP8266 i2c version (wip)
    [Configuration.h]
2018-05-02 Clean up old stuff, see the legacy branch for that
    [Configuration.h, vibhub_0.1.sch]
2018-05-02 remove ESP32
    [ESP32 Devboard Pins.ods]
2018-05-04 Added sketch for testing PCA9634 function
    Does sin wave across the 8 channels
    Blinks GPIO15
    Scans I2C bus for active addresses on boot
2018-05-19 Finished DRV8833 intergration
    [Configuration.h]
2018-05-22 Added devboard PCB
    [devboard.brd, devboard.sch]
2018-05-22 Added gerber.cam
2018-05-24 Revised dev board PCB layout Added rough draft BOM
    [bom.csv, devboard.brd, devboard.sch]
2018-05-24 Formated BOM
    [bom.csv, bom.ods]
2018-05-25 Updated dev board, replaced some parts that are not generally available
    [bom.ods, devboard.brd, devboard.sch]
2018-05-25 Fixed silkscreen
    [devboard.brd]
2018-05-25 Updated BOM
    [bom.ods]
2018-05-25 Increased motor driver current
    [bom.ods, devboard.brd, devboard.sch, seed_bom.csv]
2018-05-27 Final changes to dev board for manufacture
    [bom.ods, devboard.brd, devboard.sch]
2018-05-29 Updated BOM Renamed 1.0 gerber zip Removed unneeded temp file
    [bom.ods, seed_bom.csv]
2018-05-29 Changed fuse rating
    [bom.ods, devboard.brd, devboard.sch]
2018-05-29 Add schematics
    Adds some schematics
2018-05-29 - Added DEBUG_DUTY preprocessor definition to PCA9634.cpp to prevent massive spam in programs - P events now turn off programs - Fixed some program debuggery - Programs will no longer update PWM afte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
    [PCA9634.cpp, VhClient.cpp, VhMotor.cpp, VhMotor.h, VhPwm.cpp]
2018-06-03 Archived devboard 1.0
    [bom.ods, devboard.brd, devboard.sch]
2018-06-03 Fixed devboard 1.0 BOM, again
    [bom.ods]
2018-06-03 Added readme warning about 1.0 board error
2018-06-03 Started devboard 1.1
    [devboard.brd, devboard.sch]
2018-06-07 Revert "Merge branch 'master' of https://github.com/JasXSL/VibHub-ESP32"
    This reverts commit e7525410c98c27a43733a001509c30d6c5395b8a, reversing
    changes made to 8ce02802e0bd9013257f2d88e97262cd868c22ea.
    [bom.ods, devboard.brd, devboard.sch]
2018-06-09 rescript because ArduinoJson fail
    [VhClient.cpp, VhMotor.cpp, VhMotor.h]
2018-06-09 Updates to 1.1 board
2018-06-09 Revert "Merge branch 'master' of https://github.com/JasXSL/VibHub-ESP32"
    changes made to 8ce02802e0bd9013257f2d88e97262cd868c22ea. (reverted from commit 0353e5c721b89ea74c99468aca303392ed431fdb)
    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
    [bom.ods, devboard.brd, devboard.sch]
2018-06-10 Hopefully fixed PCA9634 not responding after ESP reset
    [PCA9634.cpp, PCA9634.h, VhPwm.cpp]
2018-06-11 Fixed initial motor state on (re)start
    [VhMotor.cpp]
2018-06-17 Added reset support to TweenDuino
    [Timeline.h, TweenDuinoDebugger.ino, VhMotor.cpp]
2018-06-17 Improved memory leak to be slightly less leaky Added memory use debug message
    [CaptivePortal_i2c.ino, VhMotor.cpp]
2018-06-17 Fixed memory leak with programs (hopefully)
    [VhMotor.cpp]
2018-06-18 Fixed memory leak with TweeenDuino
    [Timeline.h, TweenDuinoDebugger.ino, VhMotor.cpp]
2018-06-18 Add some debug definitions. Make short & randobj programs work.
    [CaptivePortal_i2c.ino, VhMotor.cpp]
2018-06-18 Revert "Revert "Merge branch 'master' of https://github.com/JasXSL/VibHub-ESP32""
    This reverts commit d77c9c4687c02bab05891224d50b813a23a65ead.
    [bom.ods, devboard.brd, devboard.sch]
2018-06-18 Revert "Revert "Merge branch 'master' of https://github.com/JasXSL/VibHub-ESP32""
    This reverts commit 0353e5c721b89ea74c99468aca303392ed431fdb.
    [bom.ods, devboard.brd, devboard.sch]
2018-06-18 Index page done
    [Configuration.h]
2018-06-19 Updated devboard 1.1
    [devboard.brd, devboard.sch]
2018-06-21 Updated 1.1 board
    [devboard.brd, devboard.sch]
2018-06-24 1.1 board finalizations
    [devboard.brd, devboard.sch]
2018-06-25 1.1 dev board RTM
    [devboard.brd]
2018-06-26 WiFiManager is still really buggy, but at least it looks good whenever it actually works
    [Config.cpp, VhWifi.cpp, VhWifi.h]
2018-07-05 Updated PCA9634 lib for 1.1 dev board
    [Configuration.h]
2018-07-16 Added board test sketch, initial version Currently only has basic test patterns to help verify assembly
2018-07-20 Updated board test
2018-08-07 DeviceID is now 12 bytes, uppercase, and has numbers. Removed unused generateDeviceID method Made deviceID use a monospace font
2018-08-21 - Fix for randObjects max nr being off by 1 - Fix for motor maxing out after completing the first program upon reset
    [VhMotor.cpp, VhPwm.cpp]
2018-08-22 Increase tween timeline max size. It should now support some 40 or so stages
2018-08-29 Backports tweening from ESP32
2018-08-30 Removes the custom CSS and adds device ID to the config page. Should work with the low memory ESP8266
2019-08-08 Remove some esp32 stuff
    [Configuration.h]
